shuomengeng/autonomous-parking-vehicle/ENGMT280_Car_v2.SLDASM

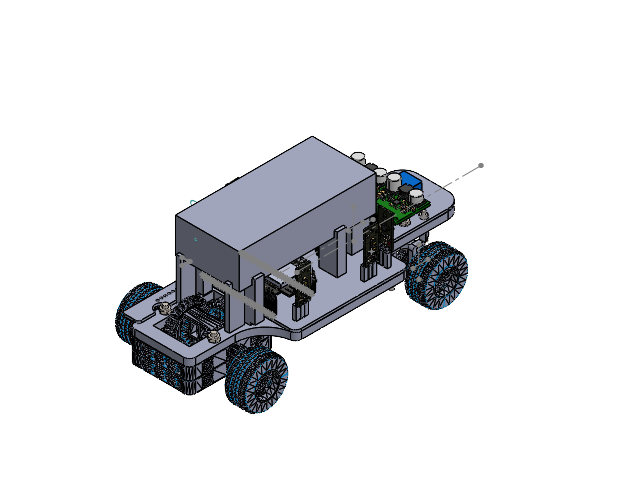
[picture p20: CAD file, 2026-10-21]
ENGMT280_Car_v2.SLDASM
MainBody
FullDiffAssy
tire x 2
wheel x 2
LegoMotorCoupling10mm
pan cross head screw_as x 10
xAxle3L x 2
FS09R_Servo_Motor
mmgm_90Deg
Servo horn v2
halfBush x 2
fullBush x 2
Linkage Bar
Acrylic bushing x 6
Linkage arm x 4
Linkage plate x 2
hexagon nut style 1 (grades a and b) as x 10
PCB
BatteryBox
DRV8835
straight_headers x 24
straight_receptacles x 62
BOSS-EXTRUDE14_8_.step
BOSS-EXTRUDE7_4_.step
BOSS-EXTRUDE7_3_.step
BOSS-EXTRUDE14_4_.step
BOSS-EXTRUDE14_2_.step
BOSS-EXTRUDE14_11_.step
BOSS-EXTRUDE7_7_.step
BOSS-EXTRUDE14_9_.step
BOSS-EXTRUDE14_3_.step
BOSS-EXTRUDE14_7_.step
MIRROR2.step
BOSS-EXTRUDE14_5_.step
BOSS-EXTRUDE14_12_.step
BOSS-EXTRUDE7_8_.step
BOSS-EXTRUDE7_1_.step
BOSS-EXTRUDE14_10_.step
BOSS-EXTRUDE7_9_.step
BOSS-EXTRUDE14_6_.step
CHAMFER9.step
BOSS-EXTRUDE14_1_.step
BOSS-EXTRUDE7_6_.step
BOSS-EXTRUDE7_2_.step
CUT-EXTRUDE5.step
BOSS-EXTRUDE7_5_.step
Body.step x 2
Pins.step x 2
Shield.step
U.FL-R-SMT-1_10_ v1.step
DF40C-30DP-0.4V_51_ v1.step
Seeed Studio XIAO-ESP32-S3 (Sense)-0.step
DF40HC(3.0)-30DS.step
10067099-200LF v1.step
PCB.step
MicroSD v2.step
JUSHUO AFC01-S24FCA-00.step
Camer Module.step
irs17a x 5
angled_receptacles x 15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
