shuomengeng/autonomous-parking-vehicle/(list of files, cad)

Other CAD files:
PCB final.DXF
PCB.DXF
